cese-dci/tp-dci--evolentini/README.md

# Punku, Control de Accesos

## Diagramas de Hardware

Este repositorio contiene el los diagramas esquematicos y diseño de placas del equipo apra control de accesos Punku. Los mismo estan realizados utilizando la el programa [KiCad](http://kicad-pcb.org/)
