cese-dci/tp-dci--evolentini/librerias/readme.md

# Librerias KiCad #

Repositorio GIT que contiene el desarrollo de las librerias de componetens para ser utilizadas con KiCad.

### Como se utiliza el repositorio ###

En general este repositorio esta pensado para ser utilizado como un submodulo del repositorio del proyecto de hardware correspondiente. En este caso el mismo se clona automaticamente cuando se clona el repositorio padre.
