cese-dci/tp-dci--evolentini/librerias/modelos/CD-MBL2xxS.step

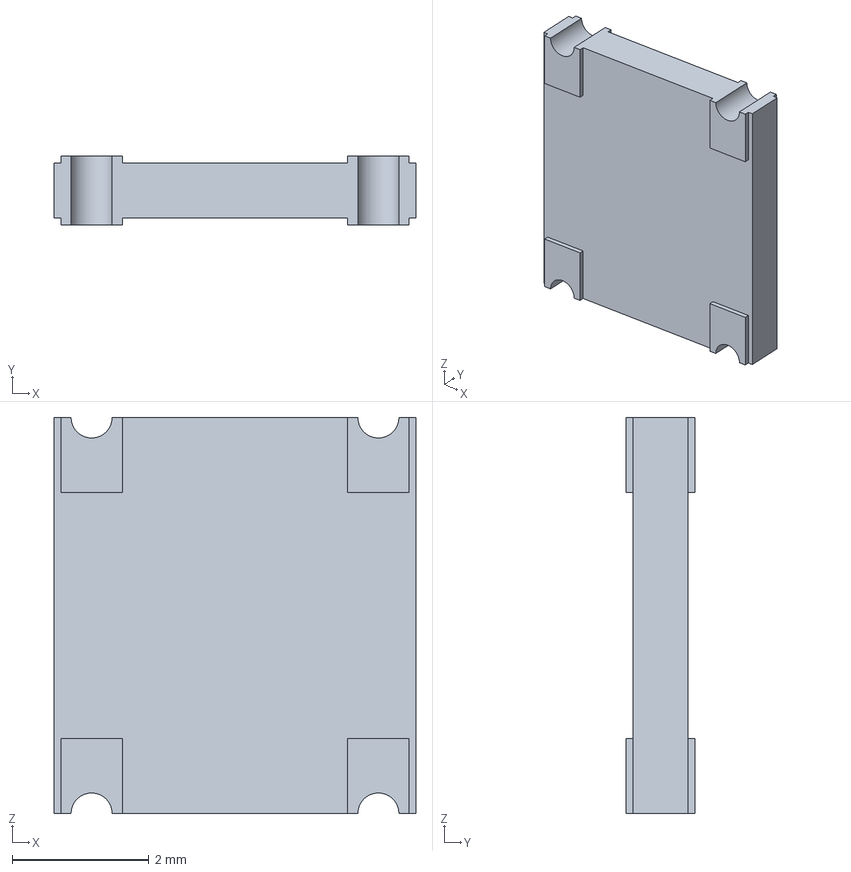
[picture p1: CAD file, 2019-10-04]
librerias/modelos/CD-MBL2xxS.step
5.30 x 1.01 x 5.80 mm
