cese-dci/tp-dci--evolentini/librerias/modelos/NT78.step

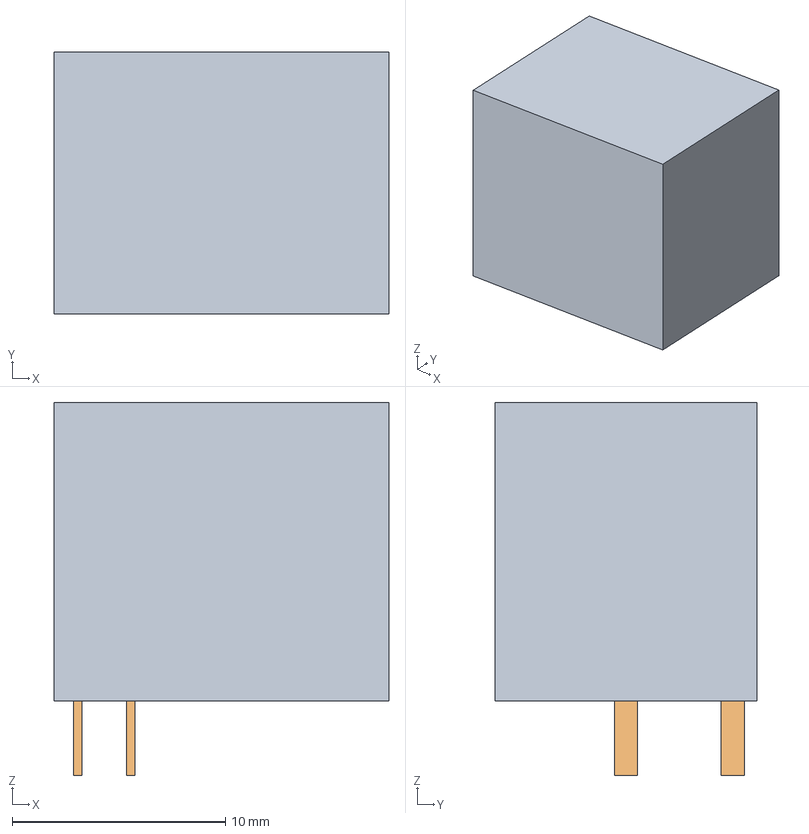
[picture p2: CAD file, 2019-10-04]
librerias/modelos/NT78.step
15.7 x 12.3 x 17.5 mm
Cuerpo
Pata1
Pata2
