cese-dci/tp-dci--evolentini/(list of files, cad)

Other CAD files:
librerias/modelos/CD-MBL2xxS_3d.stp
