cese-dci/tp-dci--evolentini/ES-PUNKU2-0100/ES-PUNKU2-0100.kicad_pcb

## KiCad design ES-PUNKU2-0100/ES-PUNKU2-0100.kicad_pcb (2019-11-07)

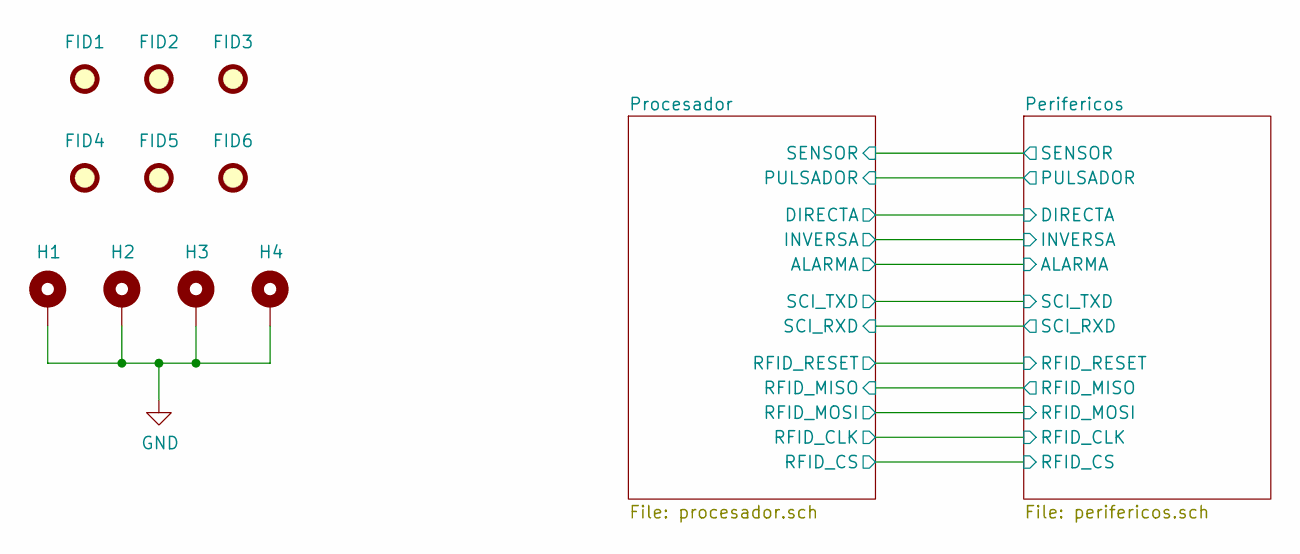
[picture p3: schematic ES-PUNKU2-0100.sch, PUNKU]

Parts:
FID1, FID2, FID3, FID4, FID5, FID6: Fiducial; Fiducial_0.5mm_Mask1mm
H1, H2, H3, H4: MountingHole_Pad; MountingHole_4mm_Pad

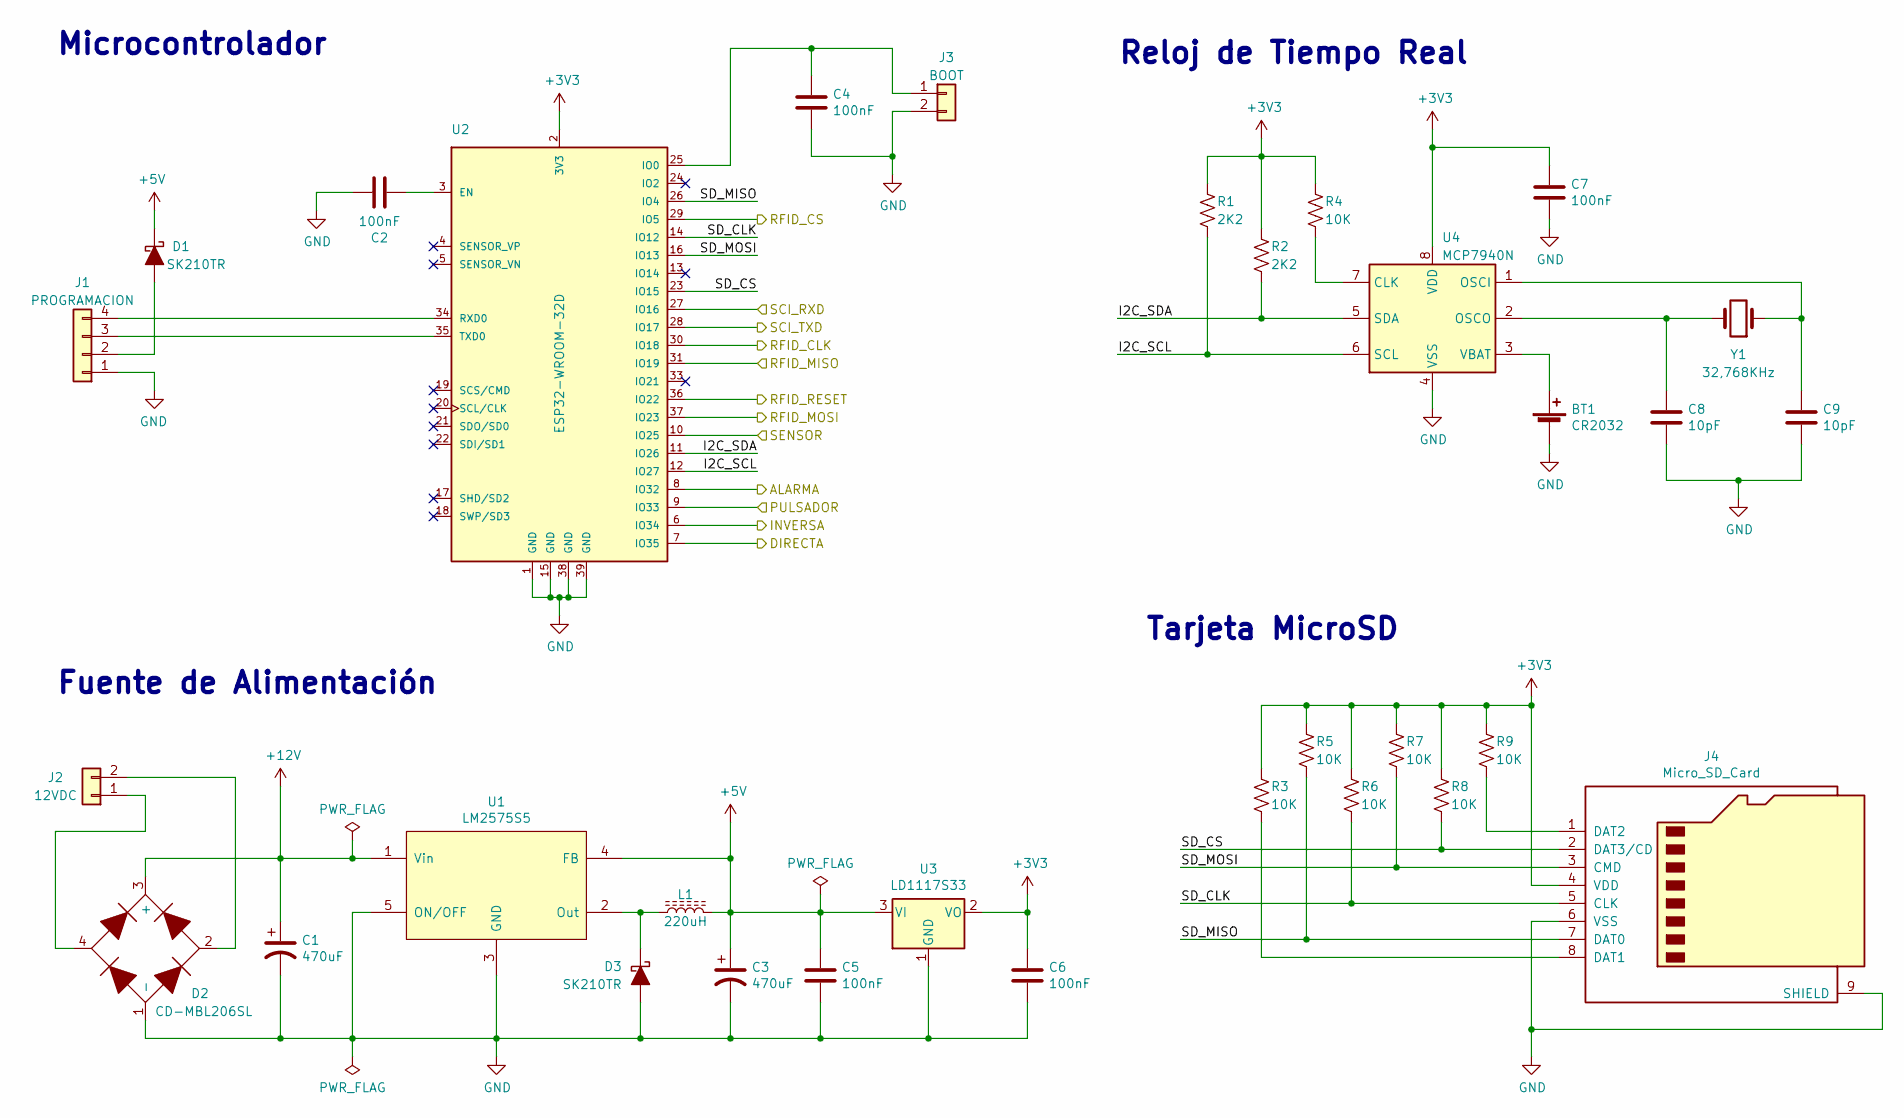
[picture p4: schematic procesador.sch, PUNKU]

Parts:
BT1: CR2032; BatteryHolder_Keystone_1058_1x2032; DigiKey 36-1058-ND
C1, C3: 470uF; CP_Elec_8x10
C2, C4, C5, C6, C7: 100nF; C_1206_0805_Dual
C8, C9: 10pF; C_1206_0805_Dual
D1, D3: SK210TR; DO-214AA; DigiKey 1655-1584-1-ND
D2: CD-MBL206SL; BOURNS-0.23x0.20; DigiKey CD-MBL206SLCT-ND
J1: PROGRAMACION; Pin_Header_Straight_1x04_Pitch2.54mm
J2: 12VDC; Bornera_Recta_2_0.200_Inch
J3: BOOT; Pin_Header_Straight_1x02_Pitch2.54mm
J4: Micro_SD_Card; SD_AMPHENOL_114_00841_68; DigiKey 114-00841-68-1-ND
L1: 220uH; BOURNS_INDUCTOR_SRR1260; DigiKey SRR1280-331KLCT-ND
R1, R2: 2K2; R_1206_0805_Dual
R3, R4, R5, R6, R7, R8, R9: 10K; R_1206_0805_Dual
U1: LM2575S5; D2PAK_TO-263_5Patas; DigiKey LM2575S-5.0/NOPB-ND
U2: ESP32-WROOM-32D; MODULE_ESP32-WROOM-32D; DigiKey 1904-1023-1-ND
U3: LD1117S33; SOT-223-3_TabPin2; DigiKey 497-1241-1-ND
U4: MCP7940N; SOIC-8; DigiKey MCP7940NT-I/SNCT-ND
Y1: 32,768KHz; CRISTAL_EPSON_3,2mm_1,5mm; DigiKey SER4089CT-ND

Connections:
+3V3: C6.1, C7.1, J4.4 (VDD), R1.1, R2.1, R3.1, R4.1, R5.1, R6.1, R7.1, R8.1, R9.1, U2.2 (3V3), U3.2 (VO), U4.8 (VDD); also elsewhere on the board
+5V: C3.1, C5.1, D1.1 (K), L1.2, U1.4 (FB), U3.3 (VI); also elsewhere on the board
+12V: C1.1, D2.3 (+), U1.1 (Vin); also elsewhere on the board
/Perifericos/ALARMA: U2.8 (IO32); also elsewhere on the board
/Perifericos/DIRECTA: U2.7 (IO35); also elsewhere on the board
/Perifericos/INVERSA: U2.6 (IO34); also elsewhere on the board
/Perifericos/PULSADOR: U2.9 (IO33); also elsewhere on the board
/Perifericos/RFID_CLK: U2.30 (IO18); also elsewhere on the board
/Perifericos/RFID_CS: U2.29 (IO5); also elsewhere on the board
/Perifericos/RFID_MISO: U2.31 (IO19); also elsewhere on the board
/Perifericos/RFID_MOSI: U2.37 (IO23); also elsewhere on the board
/Perifericos/RFID_RESET: U2.36 (IO22); also elsewhere on the board
/Perifericos/SCI_RXD: U2.27 (IO16); also elsewhere on the board
/Perifericos/SCI_TXD: U2.28 (IO17); also elsewhere on the board
/Perifericos/SENSOR: U2.10 (IO25); also elsewhere on the board
/Procesador/I2C_SCL: R1.2, U2.12 (IO27), U4.6 (SCL)
/Procesador/I2C_SDA: R2.2, U2.11 (IO26), U4.5 (SDA)
/Procesador/SD_CLK: J4.5 (CLK), R6.2, U2.14 (IO12)
/Procesador/SD_CS: J4.2 (DAT3/CD), R8.2, U2.23 (IO15)
/Procesador/SD_MISO: J4.7 (DAT0), R5.2, U2.26 (IO4)
/Procesador/SD_MOSI: J4.3 (CMD), R7.2, U2.16 (IO13)
unnamed: BT1.1 (+), U4.3 (VBAT)
unnamed: C2.2, U2.3 (EN)
unnamed: C4.2, J3.1, U2.25 (IO0)
unnamed: C8.1, U4.2 (OSCO), Y1.2
unnamed: C9.1, U4.1 (OSCI), Y1.1
unnamed: D1.2 (A), J1.2
unnamed: D2.2, J2.2
unnamed: D2.4, J2.1
unnamed: D3.1 (K), L1.1, U1.2 (Out)
unnamed: J1.3, U2.35 (TXD0)
unnamed: J1.4, U2.34 (RXD0)
unnamed: J4.1 (DAT2), R9.2
unnamed: J4.8 (DAT1), R3.2
unnamed: R4.2, U4.7 (CLK)

Notes on the sheet:
Microcontrolador
Tarjeta MicroSD
Reloj de Tiempo Real
Fuente de Alimentación

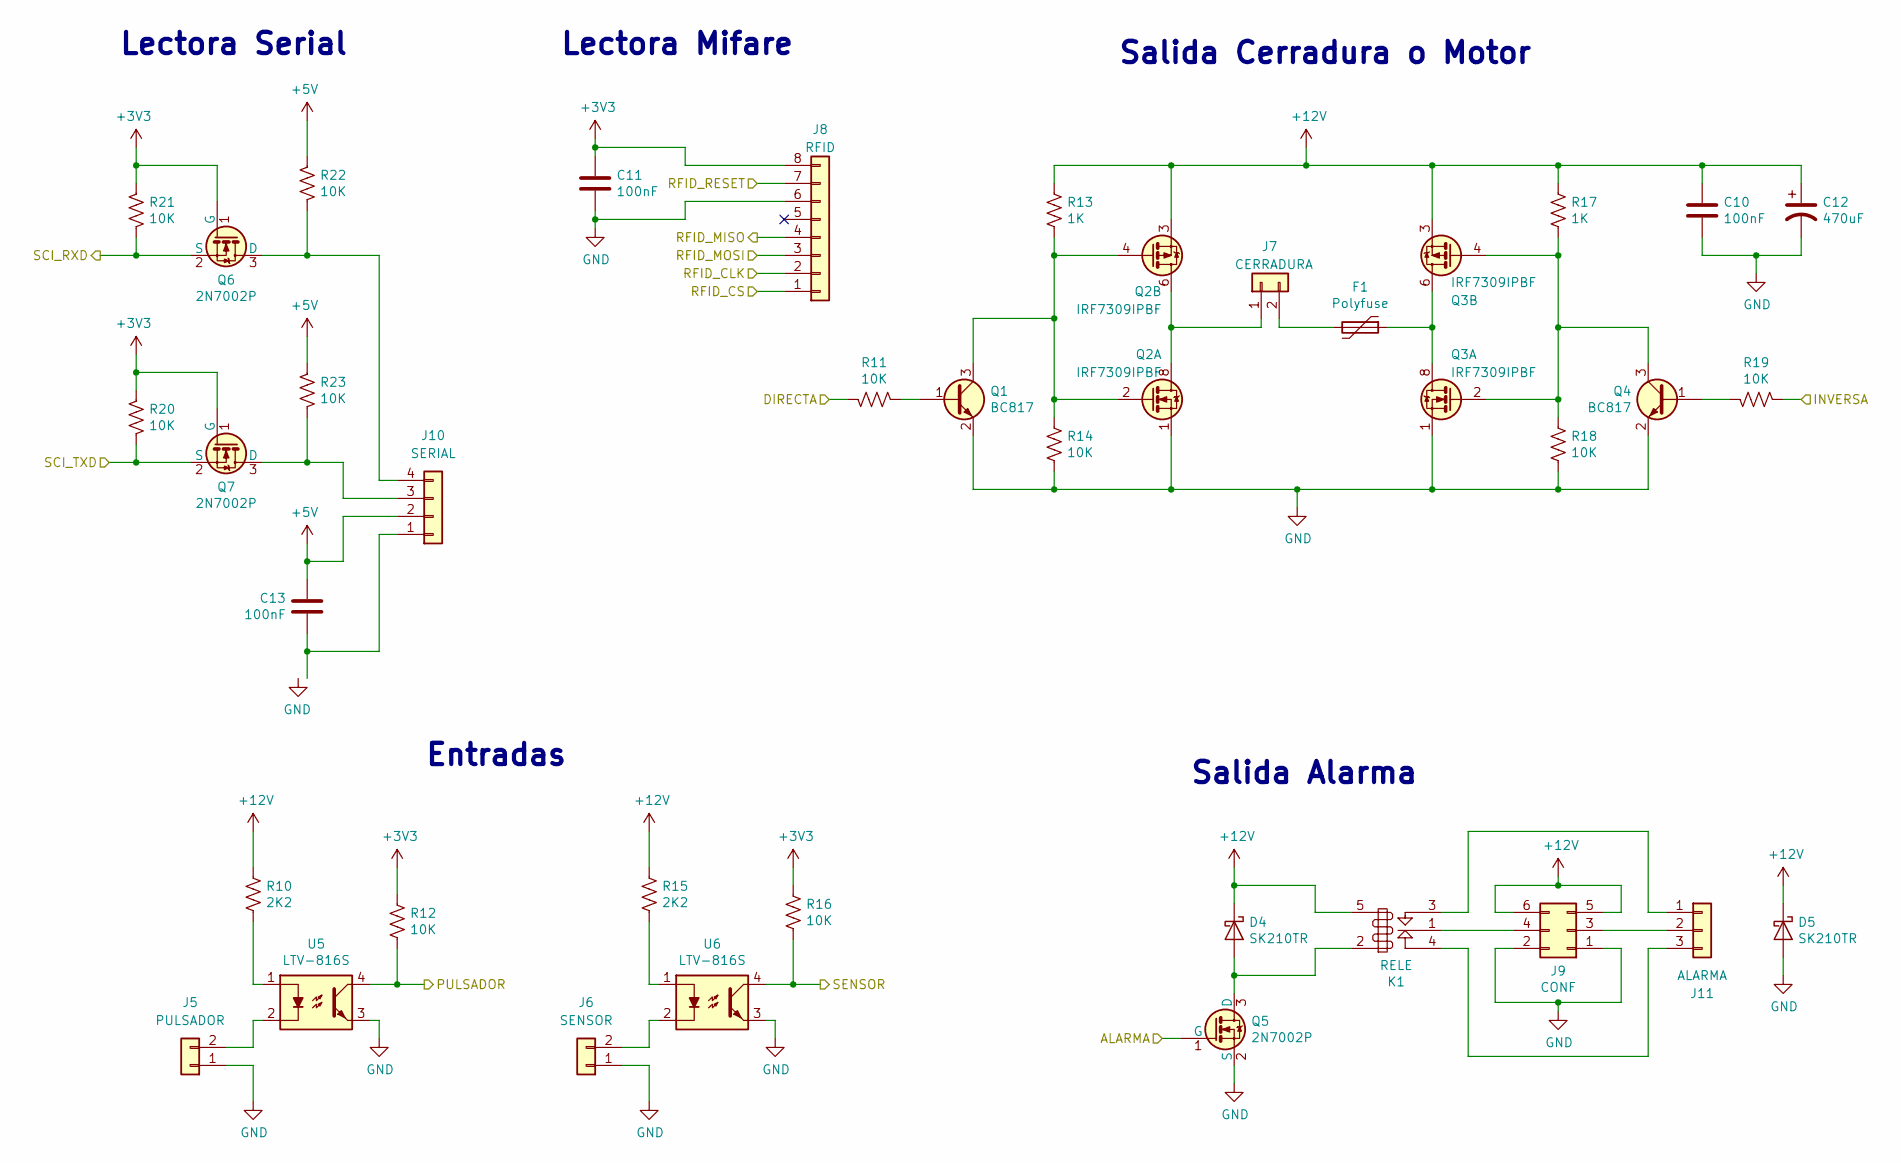
[picture p5: schematic perifericos.sch, PUNKU]

Parts:
C10, C11, C13: 100nF; C_1206_0805_Dual
C12: 470uF; CP_Elec_8x10
D4, D5: SK210TR; DO-214AA; DigiKey 1655-1584-1-ND
F1: Polyfuse; R_1812_4532Metric_Pad1.30x3.40mm_HandSolder; DigiKey 507-1773-1-ND
J5: PULSADOR; Bornera_Angulo_2_0.150_Inch
J6: SENSOR; Bornera_Angulo_2_0.150_Inch
J7: CERRADURA; Bornera_Angulo_2_0.150_Inch
J8: RFID; PinHeader_2x04_P2.54mm_Vertical_SMD
J9: CONF; Pin_Header_Straight_2x03_Pitch2.54mm
J10: SERIAL; Pin_Header_Straight_1x04_Pitch2.54mm
J11: ALARMA; Bornera_Angulo_3_0.150_Inch
K1: RELE; Relay_NT78_Series_Form_C
Q1, Q4: BC817; SOT-23; DigiKey 1727-1978-1-ND
Q2, Q3: IRF7309IPBF; SOIC-8; DigiKey IRF7309PBFCT-ND
Q5, Q6, Q7: 2N7002P; SOT-23; DigiKey 1727-4692-1-ND
R10, R15: 2K2; R_1206_0805_Dual
R11, R12, R14, R16, R18, R19, R20, R21, R22, R23: 10K; R_1206_0805_Dual
R13, R17: 1K; R_1206_0805_Dual
U5, U6: LTV-816S; DIL-8-SMD; DigiKey 160-1361-5-ND

Connections:
+3V3: C11.1, J8.8, Q6.1 (G), Q7.1 (G), R12.1, R16.1, R20.1, R21.1; also elsewhere on the board
+5V: C13.1, J10.2, R22.1, R23.1; also elsewhere on the board
+12V: C10.1, C12.1, D4.1 (K), D5.1 (K), J9.5, J9.6, K1.5 (B2), Q2.3 (1), Q3.3 (1), R10.1, R13.1, R15.1, R17.1; also elsewhere on the board
/Perifericos/ALARMA: Q5.1 (G); also elsewhere on the board
/Perifericos/DIRECTA: R11.2; also elsewhere on the board
/Perifericos/INVERSA: R19.1; also elsewhere on the board
/Perifericos/PULSADOR: R12.2, U5.4; also elsewhere on the board
/Perifericos/RFID_CLK: J8.2; also elsewhere on the board
/Perifericos/RFID_CS: J8.1; also elsewhere on the board
/Perifericos/RFID_MISO: J8.4; also elsewhere on the board
/Perifericos/RFID_MOSI: J8.3; also elsewhere on the board
/Perifericos/RFID_RESET: J8.7; also elsewhere on the board
/Perifericos/SCI_RXD: Q6.2 (S), R21.2; also elsewhere on the board
/Perifericos/SCI_TXD: Q7.2 (S), R20.2; also elsewhere on the board
/Perifericos/SENSOR: R16.2, U6.4; also elsewhere on the board
unnamed: D4.2 (A), K1.2 (B1), Q5.3 (D)
unnamed: F1.1, Q3.5 (D), Q3.6 (D), Q3.7 (D), Q3.8 (D)
unnamed: F1.2, J7.2
unnamed: J5.2, U5.2
unnamed: J6.2, U6.2
unnamed: J7.1, Q2.5 (D), Q2.6 (D), Q2.7 (D), Q2.8 (D)
unnamed: J9.4, K1.1 (C)
unnamed: J10.3, Q7.3 (D), R23.2
unnamed: J10.4, Q6.3 (D), R22.2
unnamed: J11.1, K1.3 (NA)
unnamed: J9.3, J11.2
unnamed: J11.3, K1.4 (NC)
unnamed: Q1.1 (B), R11.1
unnamed: Q1.3 (C), Q2.2 (G), Q2.4 (G), R13.2, R14.1
unnamed: Q3.2 (G), Q3.4 (G), Q4.3 (C), R17.2, R18.1
unnamed: Q4.1 (B), R19.2
unnamed: R10.2, U5.1
unnamed: R15.2, U6.1

Notes on the sheet:
Entradas
Salida Cerradura o Motor
Salida Alarma
Lectora Mifare
Lectora Serial

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
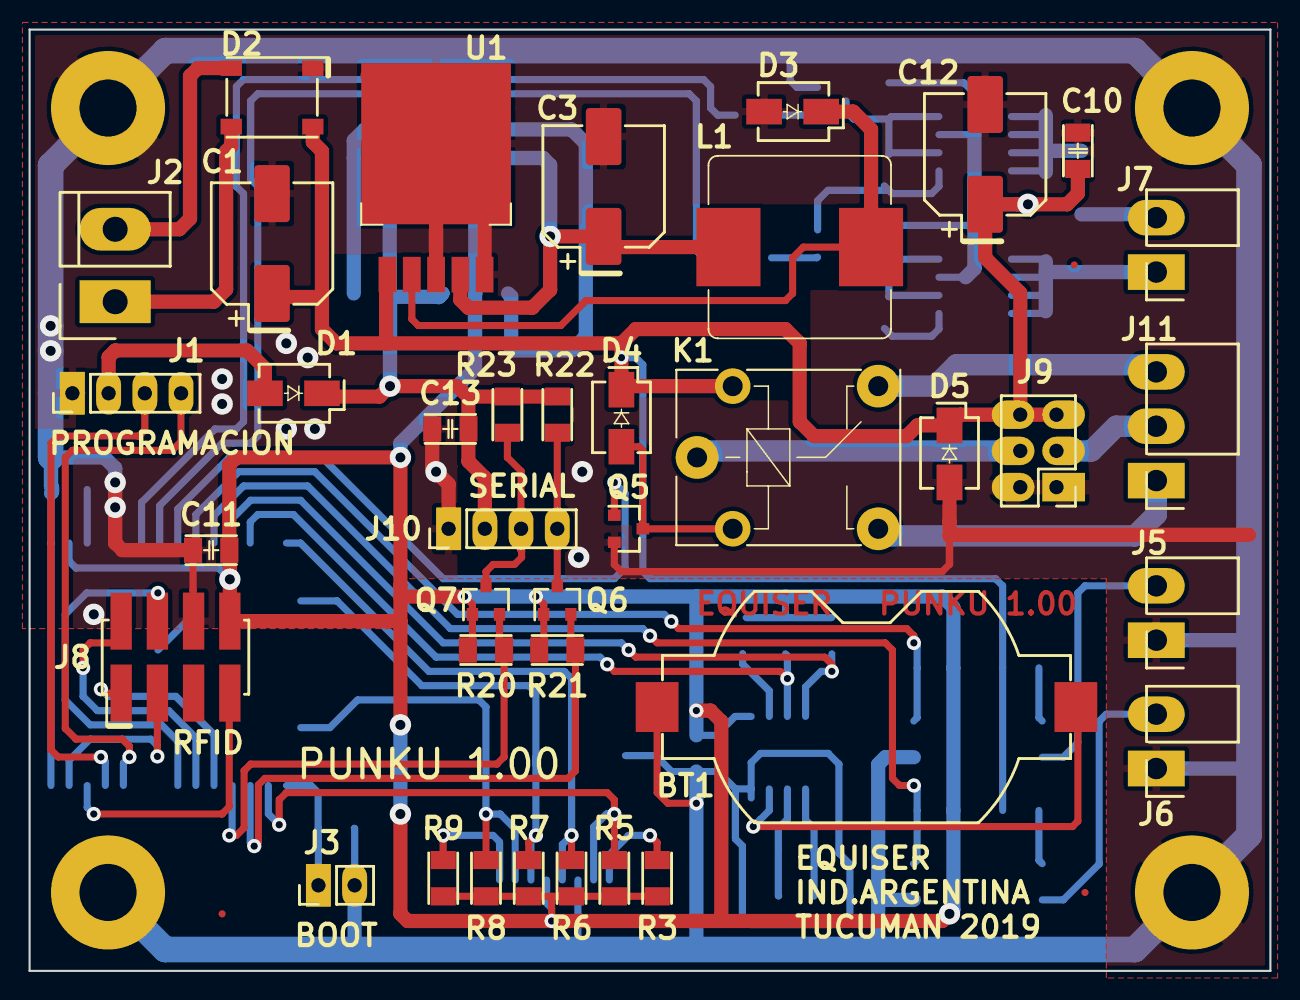
[picture p6: board ES-PUNKU2-0100.kicad_pcb from above]

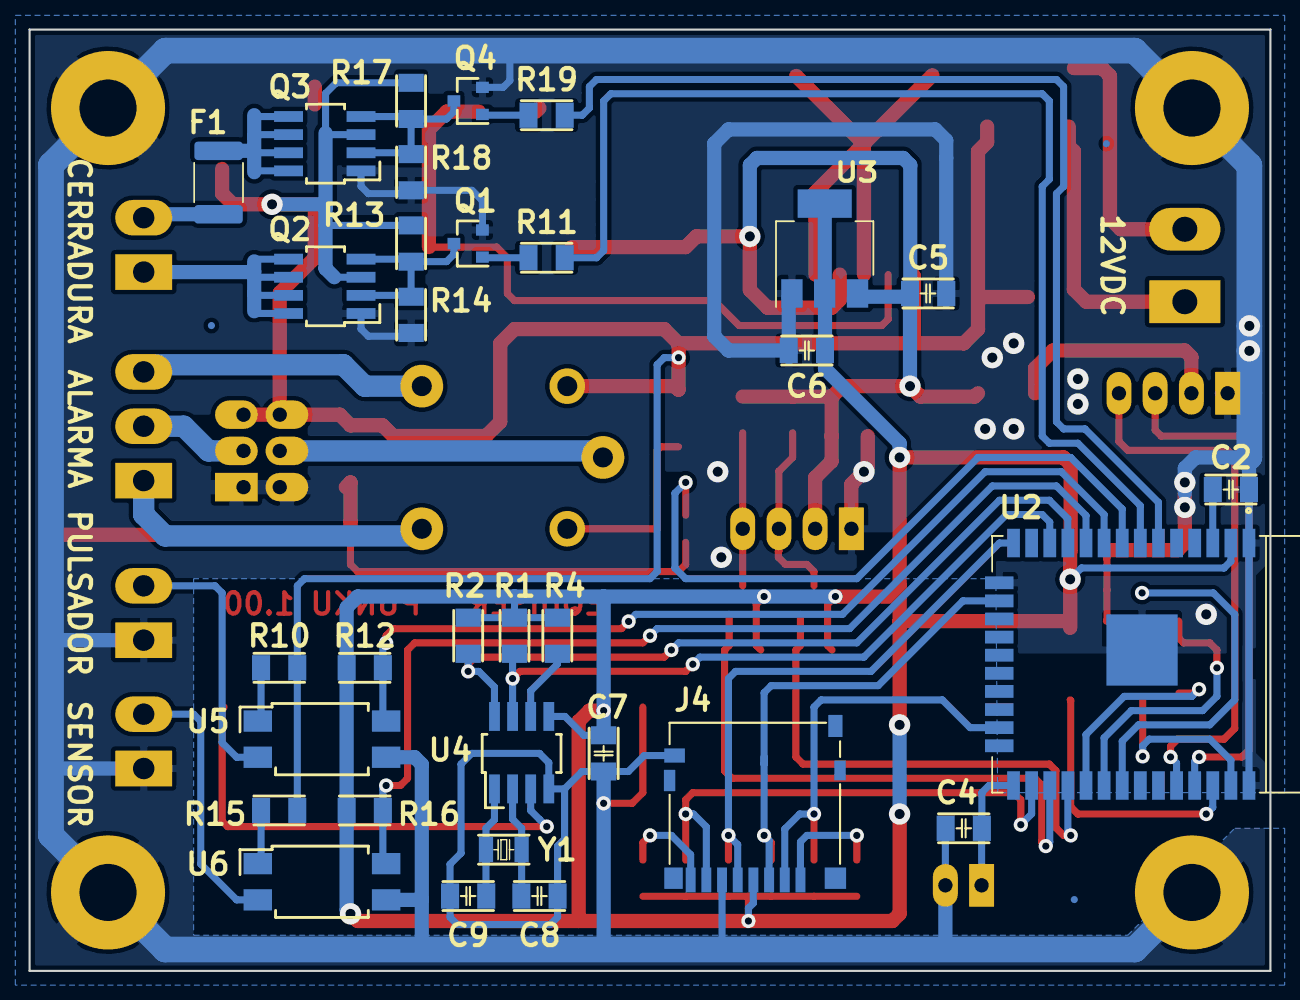
[picture p7: board ES-PUNKU2-0100.kicad_pcb from below]

Board: 2 copper layers, 87.0 x 66.0 mm, 80 parts (35 on the bottom side), 54 nets.
