cese-dci/tp-dci--evolentini/(commit log)

2019-09-12 Version inicial del diagrama esquemático y de la librería propia
    [ES-PUNKU2-0100.kicad_pcb, ES-PUNKU2-0100.sch, perifericos.sch, procesador.sch]
2019-09-23 Correcciones al esquemático. Asignación de referencias y valores. Actualización de Librerías.
    [CD-MBL2xxS_3d.stp, perifericos.sch, procesador.sch]
2019-10-04 Incorporación de las correcciones sugeridas por Martin Ribelotta y posicionamiento de componentes
    [CD-MBL2xxS.step, ES-PUNKU2-0100.kicad_pcb, ES-PUNKU2-0100.sch, NT78.step, perifericos.sch, procesador.sch]
2019-10-15 Primera versión ruteada de la placa
    [ES-PUNKU2-0100.kicad_pcb, perifericos.sch, procesador.sch]
2019-10-15 Correcciónes y exportacion del modelo 3D de la placa
    [ES-PUNKU2-0100.kicad_pcb, ES-PUNKU2-0100.sch]
2019-10-18 Correcciones de ruteo y agregado de una protección para la salida del puente H
    [ES-PUNKU2-0100.kicad_pcb, ES-PUNKU2-0100.sch, perifericos.sch, procesador.sch]
2019-11-07 Correcciones finales
    [ES-PUNKU2-0100.kicad_pcb]
